IceBerg-coder/IMP-AUV-Project/Testing Results/MPU6050/02.jpeg

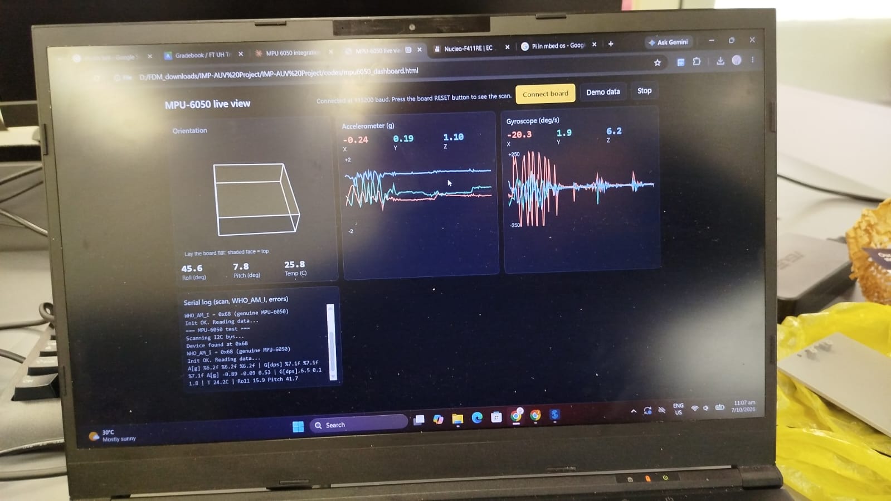
Testing Results/MPU6050/02.jpeg
