IceBerg-coder/IMP-AUV-Project/Testing Results/MPU6050/01.jpeg

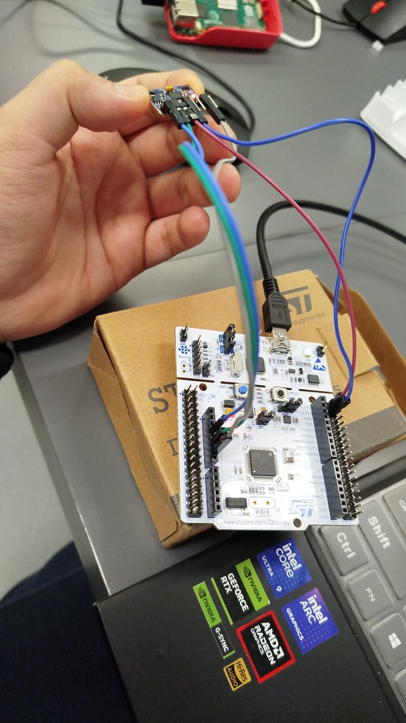
Testing Results/MPU6050/01.jpeg
