IceBerg-coder/IMP-AUV-Project/Project Docs/3S LiPo Battery Power-2026-10-09-130725.png

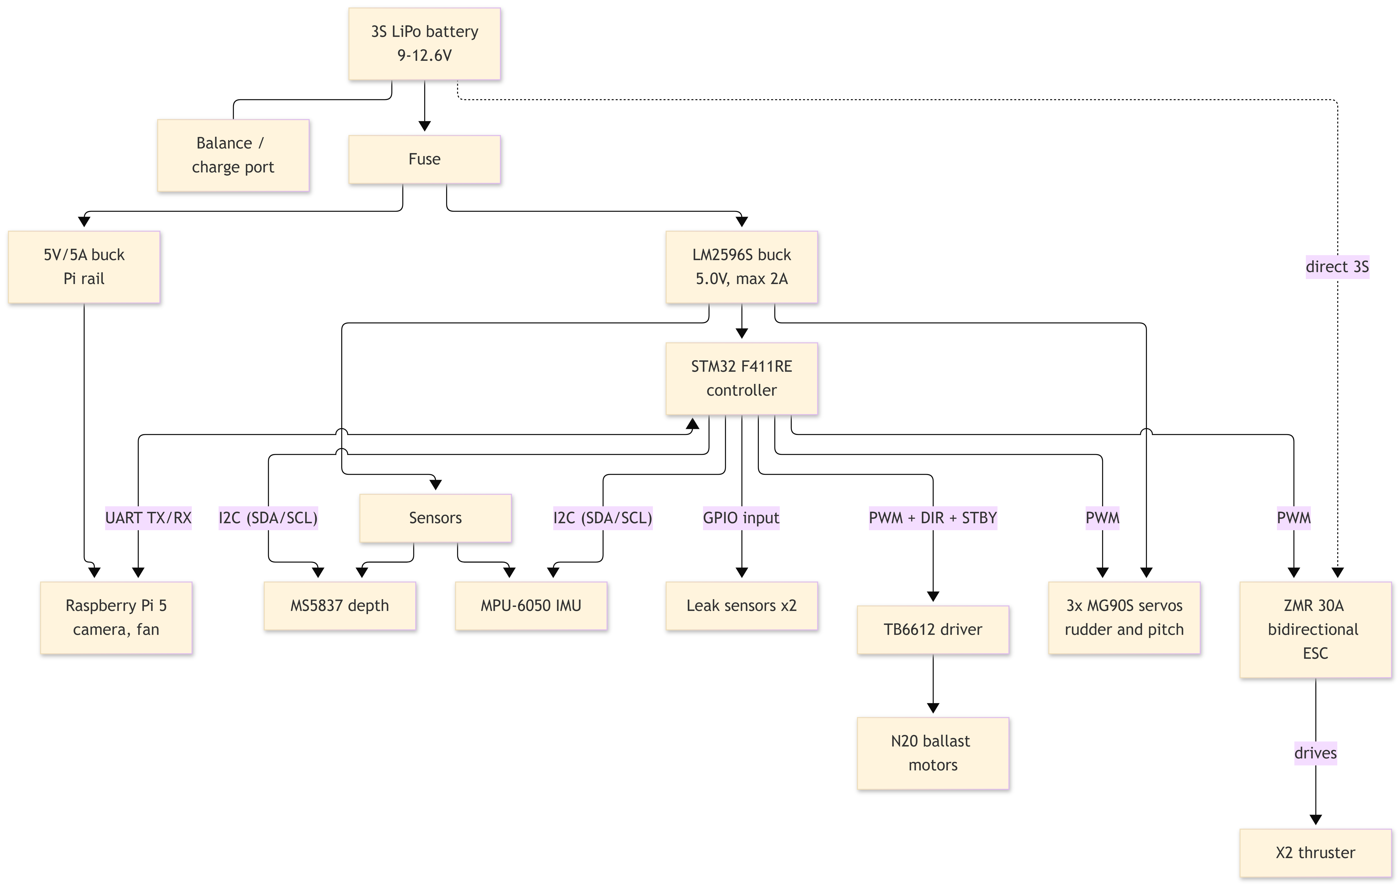
Project Docs/3S LiPo Battery Power-2026-10-09-130725.png
