IceBerg-coder/IMP-AUV-Project/CAD model/Ballast_Drive_v2.FCStd

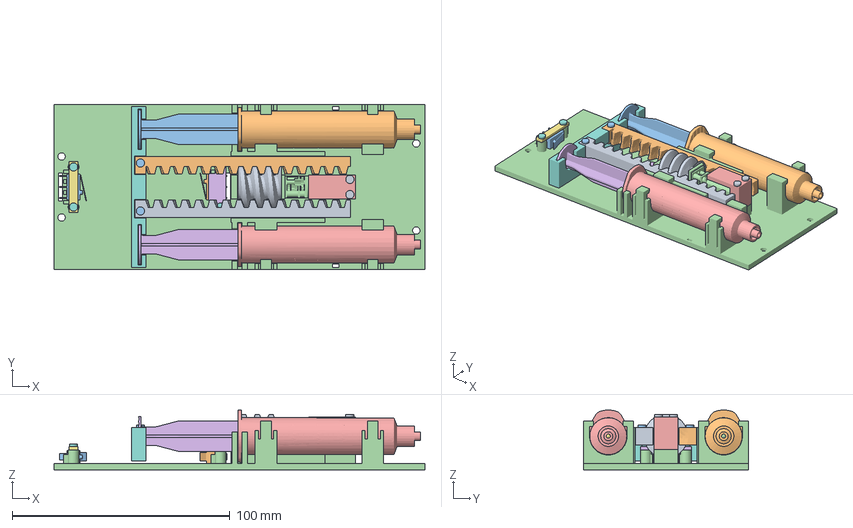
[picture p8: CAD file, 2026-10-09]
CAD model/Ballast_Drive_v2.FCStd
170.4 x 76.0 x 27.5 mm
Worm_R10_N20_bore_3.3mm
Syringe_Barrel_Port
Syringe_Plunger_Port
Syringe_Seal_Port
Syringe_Barrel_Stbd
Syringe_Plunger_Stbd
Syringe_Seal_Stbd
Yoke_PETG
Rack_Insert_Stbd_PETG
Rack_Insert_Port_PETG
Rack_Screws_M2x14
Chassis_PETG
N20_Cap_PETG
Switch_Strap_Empty_PETG
Switch_Strap_Full_PETG
Switch_Screws_M2x10
N20_Cap_Screws_M2x20
NB_Limit_Switch_Empty_12x6x6
NB_Limit_Switch_Full_12x6x6
GA12-N20 Motor (reference mesh)
