IceBerg-coder/IMP-AUV-Project/CAD model/AUV_Prototype_v5.FCStd

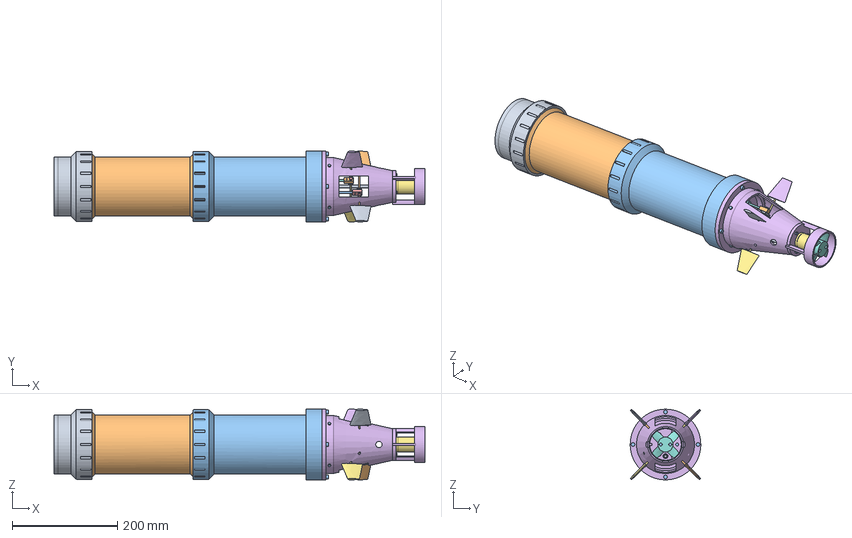
[picture p9: CAD file, 2026-10-09]
CAD model/AUV_Prototype_v5.FCStd
703.4 x 134.3 x 134.3 mm
11_Hull_Nose_Cap_ScrewOn_PETG
10b_Hull_Front_Tube_PETG
10b_Hull_Rear_Tube_PETG_with_Collar
NB_Camera_Window_Acrylic_44x4
NB_ORing_Hull_Joint_110x3_x2
11_EndCap_Rear_PETG_Service
12_ORing_Rear_Spigot_x2
NB_Vent_Plug_M5
24_Servo_A_MG90S
24_Servo_B_MG90S
NB_Sled_Segment_A_PETG
NB_Sled_Segment_B_PETG
NB_Sled_Segment_C_PETG
NB_Tail_Cone_PETG_Flooded
25_Fin_Shaft_1_3mm
25_Pushrod_1_3mm_SS
25_Fin_Horn_1_Slotted
25_RodEnd_Block_Fin_1
25_RodEnd_Block_Servo_1
24_Servo_A_Horn
24_Servo_A_Arm_Slotted
25_XFin_1_a
25_XFin_1_b
25_Pushrod_Gland_1
25_Gland_ORing_1
25_Fin_Shaft_2_3mm
25_Pushrod_2_3mm_SS
25_Fin_Horn_2_Slotted
25_RodEnd_Block_Fin_2
25_RodEnd_Block_Servo_2
24_Servo_B_Horn
24_Servo_B_Arm_Slotted
25_XFin_2_a
25_XFin_2_b
25_Pushrod_Gland_2
25_Gland_ORing_2
25_Linkage_Screws_M3
NB_Thruster_Mount_with_Duct_PETG
06_F2838_350KV_Waterproof_Motor
NB_Propeller_60mm_4blade_PETG
NB_Thruster_Cable
NB_Cable_Gland_Thruster
NB_Fasteners_M3_M4
05_MS5837_30BA_Depth
03_PiCamera_Module2
01_RaspberryPi5_8GB
19_MicroSD_64GB
17_Fan_5V_30mm
02_STM32_Nucleo_F411RE
04_MPU6050_IMU
23_TB6612FNG_Driver
18_LeakSensor_Front_LM393
18_LeakSensor_Rear_LM393
18_LeakSensor_Front_Plate
18_LeakSensor_Rear_Plate
15_Buck_5V5A_Pi
16_Buck_5V2A_Sensors
07_ESC_30A_Bidirectional
20_Fuse_40A_Holder
13_LiPo_3S_2800mAh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
