IceBerg-coder/IMP-AUV-Project/Project Docs/6FTC2062_BEng_IMP_Part_A_Kaung_Linn_Aung_Logbook_4.docx

# Logbook 4

Name: | Kaung Linn Aung
Week Date: | Part B -Meeting 4 of 8

(The above information is for you to keep track of which week this log is applicable for. This information is not required in the online logbook as the system will find your name, your supervisor’s name, and take the submission date, automatically. You must submit the online log in the relevant week. Logs cannot be backdated to missed weeks.)

Meeting date: (please note if no meeting is planned this week) | Date and day 26 July 2026

Work Undertaken this week:

Not more than 500 words

From the last meeting until now, what have you done based on the task you have listed in the last logbook?

1. Fusion 360 License Activation: full parametric design capabilities enabled through university administration licensing.
2. Microcontroller Suitability Research: Technical analysis performed on the intended secondary MCU, to ensure that it meets the power requirements, has sufficient GPIO pins for the three brushless ESCs, and that the sensor library is supported.
3. 3D Geometry Migration: Geometric boundaries (110mm diameter x 500mm length) were migrated from Tinkercad to Fusion 360 and used to model the internal equipment sled and verify clearances for physical parts.

Problems encountered:

(Not more than 500 words

What are the tasks that are still outstanding to write your Project Outline

1. A power budget shortfall has been found. As they were testing the secondary MCU, it was found that the Pi 5 officially requires a 5V/5A supply, but the design already has a single 5V/4A buck converter for the Pi 5, MCU, sensors and fan, which is too small even without the MCU. Requires a fix (split regulator rails or upsize) prior to finalizing of the BOM.
2. A budget for hull length could not be verified in CAD. As of yet, the only parts that have been added to Fusion 360 are the Pi 5 and secondary MCU, and a quick approximation of all the planned parts shows that the equipment sled may end up being approximately 625mm from nose to tail, which is about 125mm longer than the hull. To be confirmed after all parts have been modeled.
3. Mid-evaluation change of MCU. Initial suitability testing was performed on the ESP32-WROOM-32, but the pressure sensor used, MS5837, had been reported to be unreliable on the ESP32, and the pressure sensor was not as well tested as the other sensors on the Nucleo-F411RE, so the evaluation was repeated on the Nucleo-F411RE.

Tasks agreed for upcoming week before the next meeting | What are your plan actions/task until the next progress meeting that are agreed with your supervisor 1. To write the project outline and submit on time.

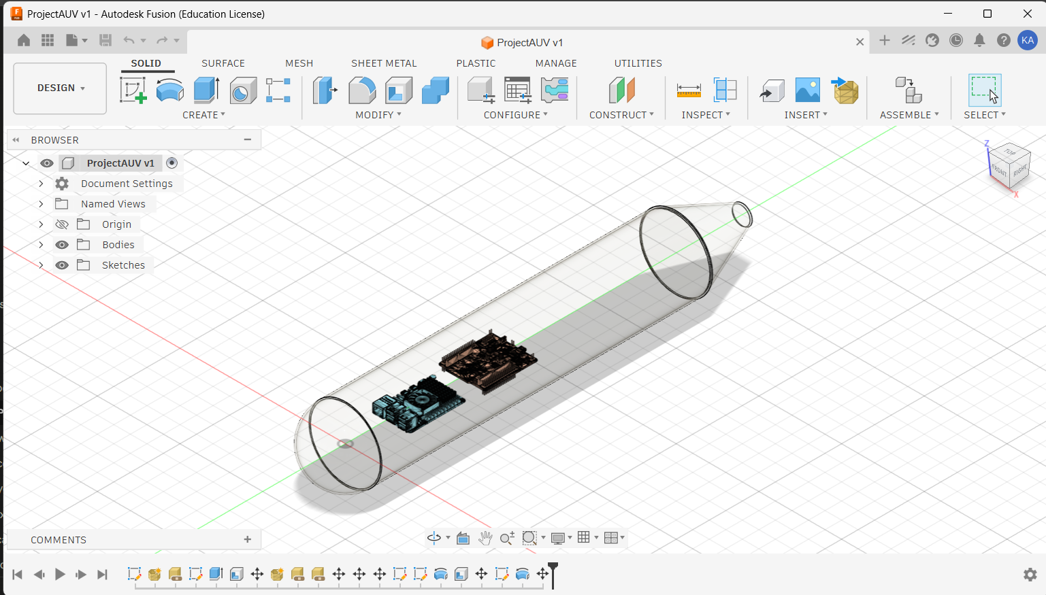
[picture p15: figure]

Figures: (Upload image files in the online Log Form, but feel free to keep notes here about which images you intend to upload. Use “Figure Caption” information as the filenames, e.g., “Figure 1 – A screenshot of the initial constrained Sketch in CATIA.jpg”) | Figure 1 Screenshot of ProjectAUV v1 in Autodesk Fusion 360, showing the 110mm x 500mm hull migrated from Tinkercad with the Raspberry Pi 5 and STM32 Nucleo-F411RE boards placed inside, evidencing the completed 3D Geometry Migration task.
